strix07/Amplificador-Audio-ESP8266-Control-Inalambrico/(list of files, drawings)

Other design files:
Amplificador-Audio-ESP8266-Control-Inalambrico.pdsprj
